janelia-experimental-technology/Dual-PMT-Amplifier/README.md

# Dual-PMT-Amplifier
Dual amplifier for PMTs
