janelia-experimental-technology/Dual-PMT-Amplifier/ECAD/PMT AMP_J000331REVH_BOM.xlsx

Qty | Value | Device | Package | Parts | Description | MANUFACTURER | MANUFACTURER PN | DIGIKEY PART NUMBER
6 | DNP | M01PTH | 1X01 | OUT1, OUT2, V+, V-, V2+, V2- | Header 1 | - | - | -
2 | 1x02 | M02LOCK | 1X02_LOCK | JP1, JP2 | Header 2 | Wurth | 61300211121 | 732-5315-ND (https://www.digikey.com/product-detail/en/wurth-electronics-inc/61300211121/732-5315-ND/4846823)
2 | 49.9 | RESISTOR-POWER2512WIDE | 2512LONG | R3, R23 | RES SMD 49.9 OHM 2W 2512 WIDE | Vishay Dale | RCL122549R9FKEG | RCL49.9ECT-ND (https://www.digikey.com/product-detail/en/vishay-dale/RCL122549R9FKEG/RCL49.9ECT-ND/3029233)
6 | 227161 | 5227161-9 | AMP_227161 | J2, J4, J5, J6, J7, J8 | JACK, RIGHT ANGLE, 50 OHM, PCB, BNC | TE Connectivity | 5227161-9 | A32261-ND (https://www.digikey.com/product-detail/en/te-connectivity-amp-connectors/5227161-9/A32261-ND/811159)
6 |  | 1-1634816-0 | AMP_227161 | J2, J4, J5, J6, J7, J8 | CONN NUT FOR BNC AND TNC CONN | TE Connectivity | 1-1634816-0 | A97566-ND (https://www.digikey.com/product-detail/en/te-connectivity-amp-connectors/1-1634816-0/A97566-ND/1755953)
6 |  | 1-1634817-0 | AMP_227161 | J2, J4, J5, J6, J7, J8 | CONN LOCKWSH FOR BNC & TNC CONN | TE Connectivity | 1-1634817-0 | A97567-ND (https://www.digikey.com/product-detail/en/te-connectivity-amp-connectors/1-1634817-0/A97567-ND/1755954)
16 | 0.1u | C-EUC0603 | C0603 | C8, C9, C10, C11, C12, C13, C14, C15, C28, C29, C30, C31, C32, C33, C34, C35 | CAPACITOR, European symbol | Vishay Vitramon | VJ0603Y104JXXAC | 720-1545-1-ND (https://www.digikey.com/product-detail/en/vishay-vitramon/VJ0603Y104JXXAC/720-1545-1-ND/6096542)
2 | 3.3n | C-EUC0805 | C0805 | C7, C27 | CAPACITOR, European symbol | KEMET | C0805C332F3GACTU | 399-8066-1-ND (https://www.digikey.com/product-detail/en/kemet/C0805C332F3GACTU/399-8066-1-ND/3471789)
2 | 4.7n | C-EUC0805 | C0805 | C5, C25 | CAPACITOR, European symbol | KEMET | C0805C472GAGAC7800 | 399-13494-1-ND (https://www.digikey.com/product-detail/en/kemet/C0805C472GAGAC7800/399-13494-1-ND/6126230)
2 | 68n | C-EUC0805 | C0805 | C6, C26 | CAPACITOR, European symbol | KEMET | C0805C683J5RAC7800 | 399-14629-1-ND (https://www.digikey.com/product-detail/en/kemet/C0805C683J5RAC7800/399-14629-1-ND/7103921)
2 | DNP | C-EUC0805 | C0805 | C100, C200 | CAPACITOR, European symbol | - | - | -
8 | 10u | C-EUC1206 | C1206 | C1, C2, C3, C4, C21, C22, C23, C24 | CAPACITOR, European symbol | KEMET | C1206C106J3RACAUTO | 399-15734-1-ND (https://www.digikey.com/product-detail/en/kemet/C1206C106J3RACAUTO/399-15734-1-ND/7427614)
4 | 1p | C-EUC1206 | C1206 | CF1A, CF1B, CF2A, CF2B | CAPACITOR, European symbol | KEMET | C1206C109C5GACTU | 399-1178-1-ND (https://www.digikey.com/product-detail/en/kemet/C1206C109C5GACTU/399-1178-1-ND/411453)
2 | LSM115J | DIODE-DO214BA | DO214BA | D1, D2 | DIODE | Microsemi | LSM115JE3/TR13 | LSM115JE3/TR13CT-ND (https://www.digikey.com/product-detail/en/microsemi-corporation/LSM115JE3-TR13/LSM115JE3-TR13CT-ND/1634547)
4 | PJ-002BH | POWER_JACK_SHUNTPJ-002 | PJ-002 | J1, J3, J9, J10 | CONN PWR JACK 2.5X5.5MM SOLDER | CUI | PJ-002BH-SMT-TR | CP-002BHPJTR-ND (https://www.digikey.com/product-detail/en/cui-inc/PJ-002BH-SMT-TR/CP-002BHPJTR-ND/404626)
4 | 0 | R-US_R0805 | R0805 | R100, R200, RIN1, RIN2 | RESISTOR, American symbol | Vishay Dale | CRCW08050000Z0EA | 541-0.0ACT-ND (https://www.digikey.com/product-detail/en/vishay-dale/CRCW08050000Z0EA/541-0.0ACT-ND/1180267)
4 | 100k | R-US_R0805 | R0805 | R10, R11, R30, R31 | RESISTOR, American symbol | Vishay Dale | TNPW0805100KBEEA | TNP100KABCT-ND (https://www.digikey.com/product-detail/en/vishay-dale/TNPW0805100KBEEA/TNP100KABCT-ND/1857093)
4 | 10k | R-US_R0805 | R0805 | R7, R8, R27, R28 | RESISTOR, American symbol | Vishay Dale | TNPW080510K0BEEA | TNP10.0KABCT-ND (https://www.digikey.com/product-detail/en/vishay-dale/TNPW080510K0BEEA/TNP10.0KABCT-ND/1857095)
4 | 3.74k | R-US_R0805 | R0805 | R4, R5, R24, R25 | RESISTOR, American symbol | Vishay Dale | TNPW08053K74BEEA | 541-3791-1-ND (https://www.digikey.com/product-detail/en/vishay-dale/TNPW08053K74BEEA/541-3791-1-ND/7355150)
2 | 37.4k | R-US_R0805 | R0805 | R6, R26 | RESISTOR, American symbol | Vishay Dale | TNPW080537K4BEEA | 541-3779-1-ND (https://www.digikey.com/product-detail/en/vishay-dale/TNPW080537K4BEEA/541-3779-1-ND/7355138)
4 | 715 | R-US_R0805 | R0805 | R2, R9, R22, R29 | RESISTOR, American symbol | Vishay Dale | CRCW0805715RFKEA | 541-715CCT-ND (https://www.digikey.com/product-detail/en/vishay-dale/CRCW0805715RFKEA/541-715CCT-ND/1180767)
2 | 75 | R-US_R0805 | R0805 | R1, R21 | RESISTOR, American symbol | Vishay Dale | CRCW080575R0JNEA | 541-75ACT-ND (https://www.digikey.com/product-detail/en/vishay-dale/CRCW080575R0JNEA/541-75ACT-ND/1180313)
2 | DNP | R-US_R0805 | R0805 | R101, R201 | RESISTOR, American symbol | - | - | -
2 | 20k | R-US_R1206 | R1206 | RF1, RF2 | RESISTOR, American symbol | Vishay Dale | TNPW120620K0BEEA | TNP20.0KACCT-ND (https://www.digikey.com/product-detail/en/vishay-dale/TNPW120620K0BEEA/TNP20.0KACCT-ND/1857150)
2 | 100k | R-US_R1206 | R1206 | RF1, RF2 | RESISTOR, American symbol | Vishay Dale | TNPW1206100KBEEA | TNP100KACCT-ND (https://www.digikey.com/products/en?keywords=%20%09TNP100KACCT-ND%20)
4 | 100k | R-TRIMM3006P | RTRIM3006P | R12, R13, R32, R33 | Trimm resistor | BOURNS | 3006P-1-104LF | 3006P-104LF-ND (https://www.digikey.com/products/en?keywords=3006p-1-104lf)
4 |  | SOLDERJUMPER_2WAYS | SJ_3 | FST1, FST2, SLW1, SLW2 | Solder Jumper | - | - | -
2 | OP400G | OP400SO16_W | SO16L | U2, U6 | OP AMP | Analog Devices | OP400GSZ | OP400GSZ-ND (https://www.digikey.com/product-detail/en/analog-devices-inc/OP400GSZ/OP400GSZ-ND/654260)
2 | OPA692 | AD820R | SO8 | U5, U10 | Single-Supply, Rail-to-Rail, Low Power, FET Input Op Amp | Texas Instruments | OPA692ID | OPA692ID-ND (https://www.digikey.com/product-detail/en/texas-instruments/OPA692ID/OPA692ID-ND/459282)
2 | OPA657 | AD820R | SO8 | U4, U9 | Single-Supply, Rail-to-Rail, Low Power, FET Input Op Amp | Texas Instruments | OPA657UB | OPA657UB-ND (https://www.digikey.com/product-detail/en/texas-instruments/OPA657UB/OPA657UB-ND/431976)
2 | MC78L05ACHX | 78LXXSOT89 | SOT89 | U1, U8 | VOLTAGE REGULATOR | ON Semiconductor | MC78L05ACHX | MC78L05ACHXCT-ND (https://www.digikey.com/product-detail/en/on-semiconductor/MC78L05ACHX/MC78L05ACHXCT-ND/2053106)
2 | MC79L05ACHX | 79LXXSOT89 | SOT89 | U3, U7 | VOLTAGE REGULATOR | ON Semiconductor | MC79L05ACHX | MC79L05ACHXCT-ND (https://www.digikey.com/product-detail/en/on-semiconductor/MC79L05ACHX/MC79L05ACHXCT-ND/3907987)
2 |  | PowerSupply |  |  | 5.4 Watt AC/DC Unregulated Linear Wall Adapter | Jameco | 100175 (https://www.jameco.com/webapp/wcs/stores/servlet/ProductDisplay?productId=100175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)
