janelia-experimental-technology/Dual-PMT-Amplifier/MCAD/PMT AMP Rear Panel.stp

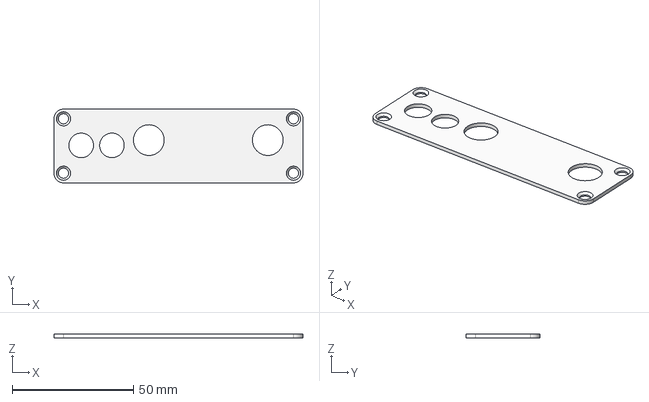
[picture p4: CAD file, 2025-08-05]
MCAD/PMT AMP Rear Panel.stp
102.9 x 30.5 x 1.50 mm
