janelia-experimental-technology/Dual-PMT-Amplifier/MCAD/PMT AMP Front Panel.stp

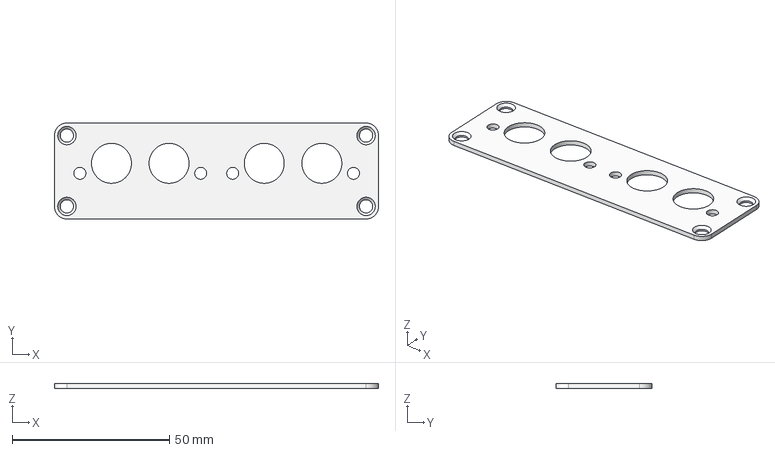
[picture p5: CAD file, 2025-08-05]
MCAD/PMT AMP Front Panel.stp
102.9 x 30.5 x 1.50 mm
