janelia-experimental-technology/Dual-PMT-Amplifier/(list of files, cad)

Other CAD files:
MCAD/PMT_AMP_REAR_PANEL_DUAL_REVA.dwg
MCAD/LABEL_NO_MECH.dwg
MCAD/PMT_AMP_FRONT_PANEL_DUAL.dwg
