janelia-experimental-technology/Dual-PMT-Amplifier/ECAD/PMT AMP_J000331REVH.pdf

2/12/2018 10:44 AM f=0.65 I:\PROJECTS\ID&F\PMT AMPLIFIER\ECAD\PMT AMP_J000331REVH\PMT AMP_J000331REVH.sch (Sheet: 1/2) SpiceOrder 1 SpiceOrder 2

# 10uGND

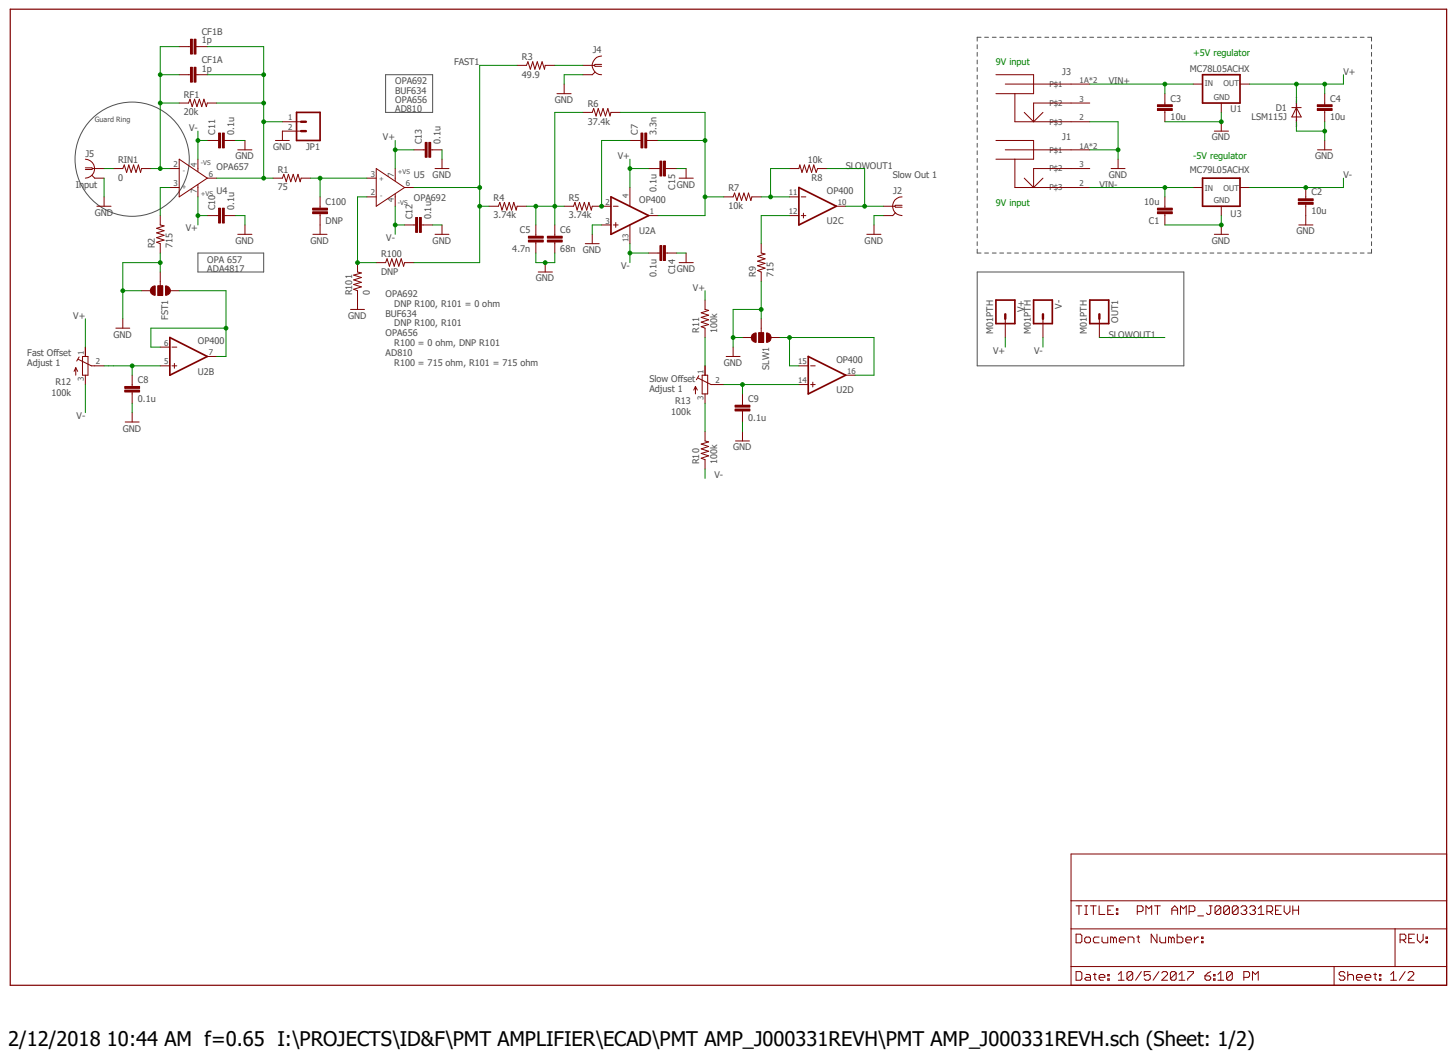
[picture p6: page 1]

49.9 0.1u GND⁰.1u GND 0.1u GND ⁰.1u GND

2/12/2018 10:44 AM f=0.65 I:\PROJECTS\ID&F\PMT AMPLIFIER\ECAD\PMT AMP_J000331REVH\PMT AMP_J000331REVH.sch (Sheet: 2/2) SpiceOrder 1 SpiceOrder 2

# 10uGND

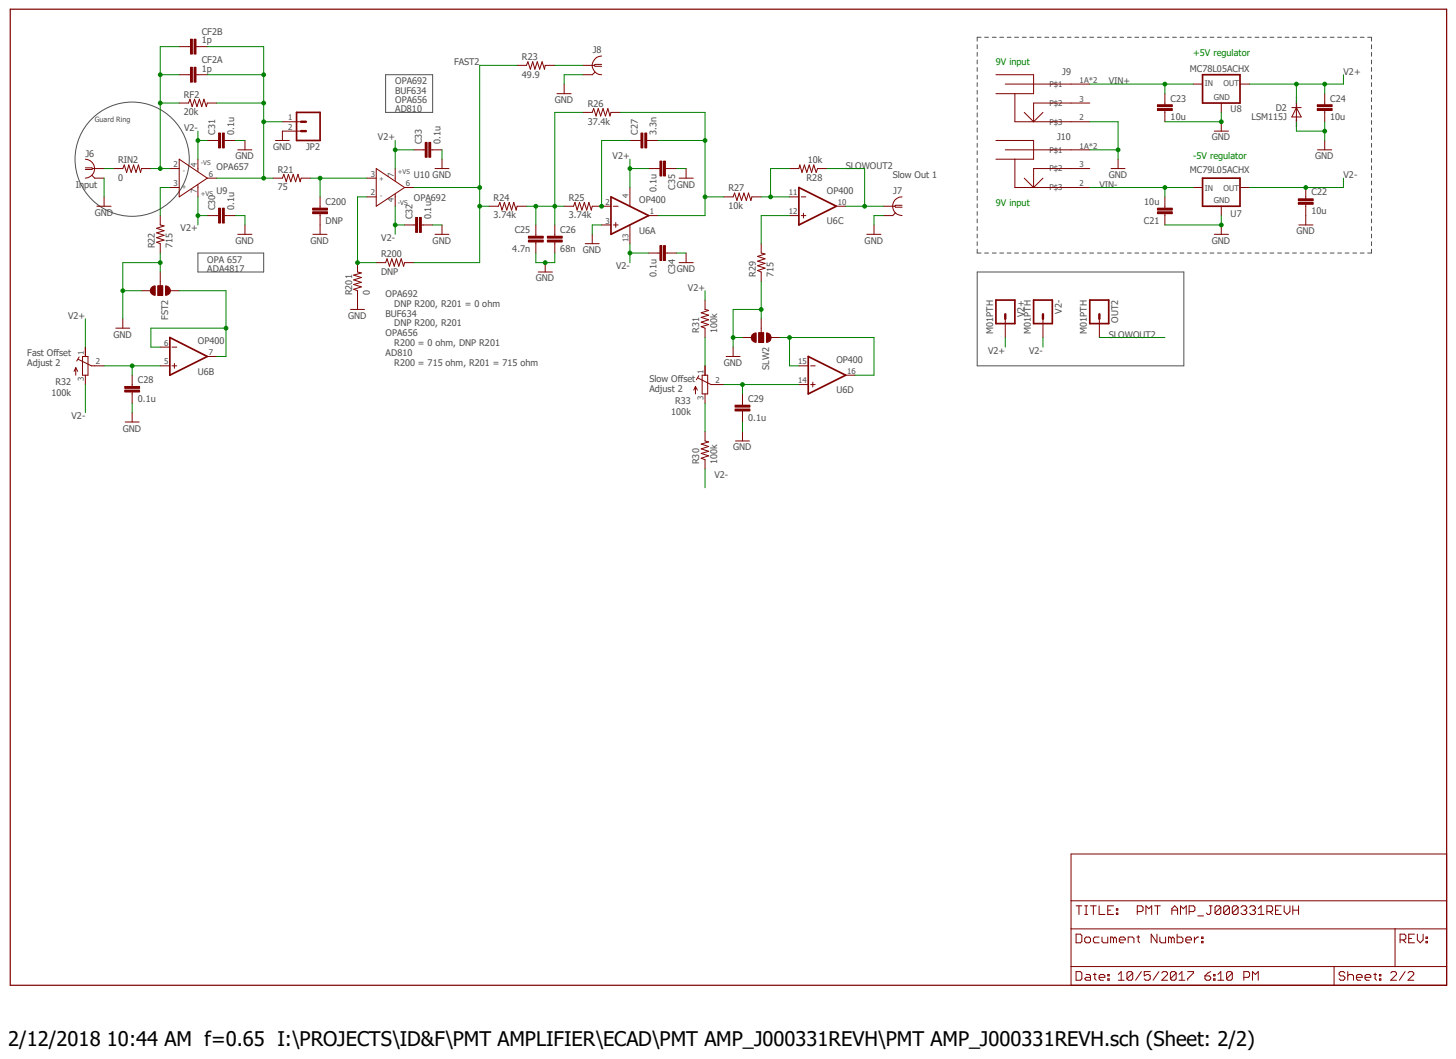
[picture p7: page 2]

49.9 0.1u GND⁰.1u GND 0.1u GND ⁰.1u GND
