janelia-experimental-technology/Dual-PMT-Amplifier/ECAD/PMT AMP_J000331REVH_pcb.pdf

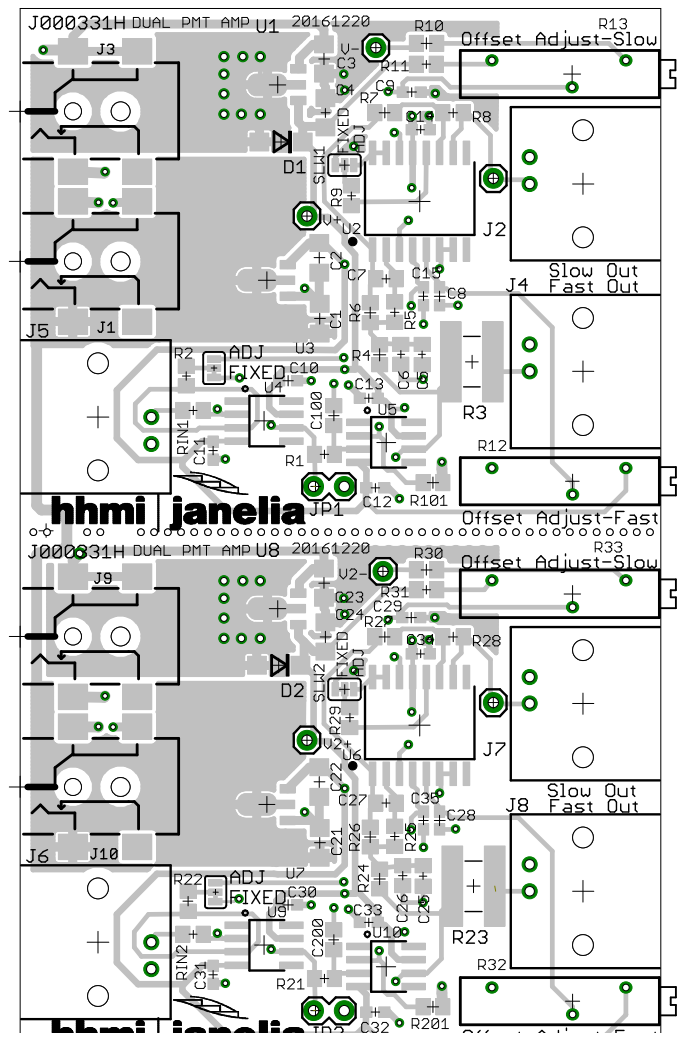
[picture p8: page 1]
