janelia-experimental-technology/Dual-PMT-Amplifier/ECAD/PMT AMP_J000331REVH.brd

## EAGLE design ECAD/PMT AMP_J000331REVH.brd (2025-08-05)

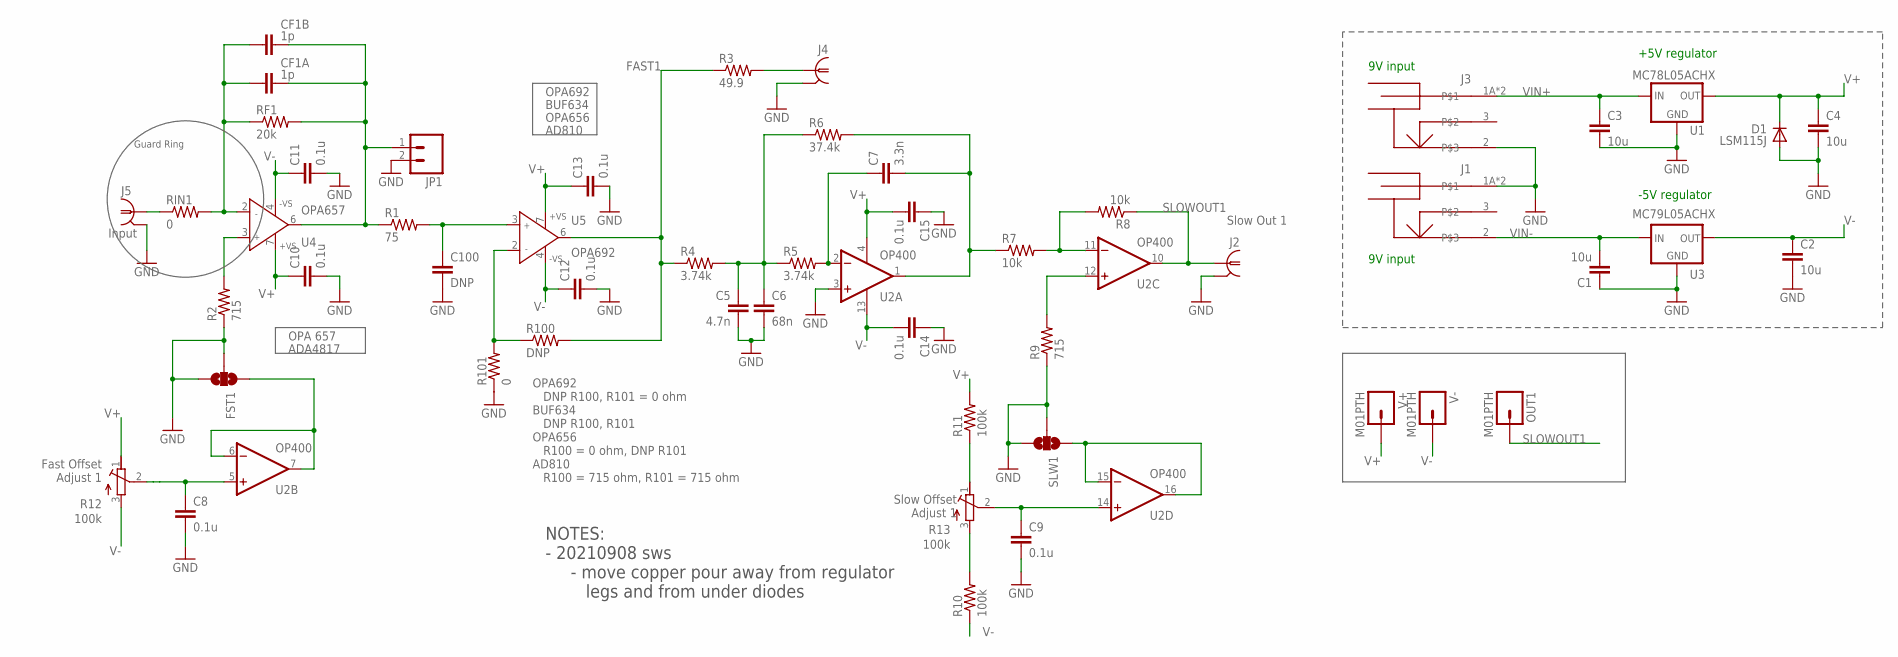
[picture p9: schematic PMT AMP_J000331REVH.sch, sheet 1]

Parts:
C1, C2, C3, C4: 10u; C1206
C5: 4.7n; C0805
C6: 68n; C0805
C7: 3.3n; C0805
C8, C9, C10, C11, C12, C13, C14, C15: 0.1u; C0603
C100: DNP; C0805
CF1A, CF1B: 1p; C1206
D1: LSM115J; DO214BA
FST1: SOLDERJUMPER_2WAYS; SJ_3
J1, J3: POWER_JACK_SHUNTPJ-002; PJ-002
J2, J4, J5: 1-227161-0; AMP_227161; MPN 5413879-1
JP1: M02LOCK; 1X02_LOCK
OUT1: M01PTH; 1X01
R1: 75; R0805
R2, R9: 715; R0805
R3: 49.9; 2512LONG
R4, R5: 3.74k; R0805
R6: 37.4k; R0805
R7, R8: 10k; R0805
R10, R11: 100k; R0805
R12, R13: 100k; RTRIM3006P; MPN 3006P-1-104LF
R100: DNP; R0805
R101: 0; R0805
RF1: 20k; R1206
RIN1: 0; R0805
SLW1: SOLDERJUMPER_2WAYS; SJ_3
U1: MC78L05ACHX; SOT89
U2: OP400; SO16L
U3: MC79L05ACHX; SOT89
U4: OPA657; SO8
U5: OPA692; SO8
V+: M01PTH; 1X01
V-: M01PTH; 1X01

Connections:
FAST1: R3.1, R4.1, R100.2, U5.6 (OUT)
FO1: J4.1, R3.2
GND: C1.1, C2.2, C3.2, C4.2, C5.2, C6.2, C8.2, C9.2, C10.2, C11.2, C12.2, C13.2, C14.1, C15.1, C100.2, D1.A, FST1.2, FST1.3, J1.1A, J1.1B, J2.2 (GND), J3.2, J4.2 (GND), J5.2 (GND), JP1.2, R2.1, R9.1, R101.1, SLW1.2, SLW1.3, U1.2 (GND), U1.2@1 (GND), U2.3 (+IN), U3.1 (GND); also elsewhere on the board
unnamed: CF1A.1, CF1B.1, RF1.1, RIN1.2, U4.2 (IN-)
unnamed: R7.2, R8.2, U2.11 (-IN)
unnamed: C100.1, R1.2, U5.3 (IN+)
unnamed: C8.1, R12.2 (S), U2.5 (+IN)
unnamed: C9.1, R13.2 (S), U2.14 (+IN)
unnamed: R11.1, R13.1 (E)
unnamed: R10.2, R13.3 (A)
unnamed: J5.1, RIN1.1
unnamed: R100.1, R101.2, U5.2 (IN-)
unnamed: C7.1, R5.2, U2.2 (-IN)
unnamed: SLW1.1, U2.15 (-IN), U2.16 (OUT)
unnamed: FST1.1, U2.6 (-IN), U2.7 (OUT)
unnamed: C7.2, R6.2, R7.1, U2.1 (OUT)
unnamed: C5.1, C6.1, R4.2, R5.1, R6.1
unnamed: R9.2, U2.12 (+IN)
unnamed: R2.2, U4.3 (IN+)
SLOWOUT1: J2.1, OUT1.1, R8.1, U2.10 (OUT)
U4OUT1: CF1A.2, CF1B.2, JP1.1, R1.1, RF1.2, U4.6 (OUT)
V+: C4.1, C10.1, C13.1, C15.2, D1.C, R11.2, R12.1 (E), U1.1 (OUT), U2.4 (V+), U4.7 (+VS), U5.7 (+VS), V+.1
V-: C2.1, C11.1, C12.1, C14.2, R10.1, R12.3 (A), U2.13 (V-), U3.3 (OUT), U4.4 (-VS), U5.4 (-VS), V-.1
VIN+: C3.1, J3.1A, J3.1B, U1.3 (IN); also elsewhere on the board
VIN-: C1.2, J1.2, U3.2 (IN), U3.2@1 (IN); also elsewhere on the board

Notes on the sheet:
9V input
+5V regulator
-5V regulator
OPA 657
ADA4817
OPA692
OPA656
AD810
Slow Offset Adjust 1
Fast Offset Adjust 1
Slow Out 1
Input
OPA692 DNP R100, R101 = 0 ohm BUF634 DNP R100, R101 OPA656 R100 = 0 ohm, DNP R101 AD810 R100 = 715 ohm, R101 = 715 ohm
Guard Ring
BUF634
NOTES: - 20210908 sws - move copper pour away from regulator legs and from under diodes

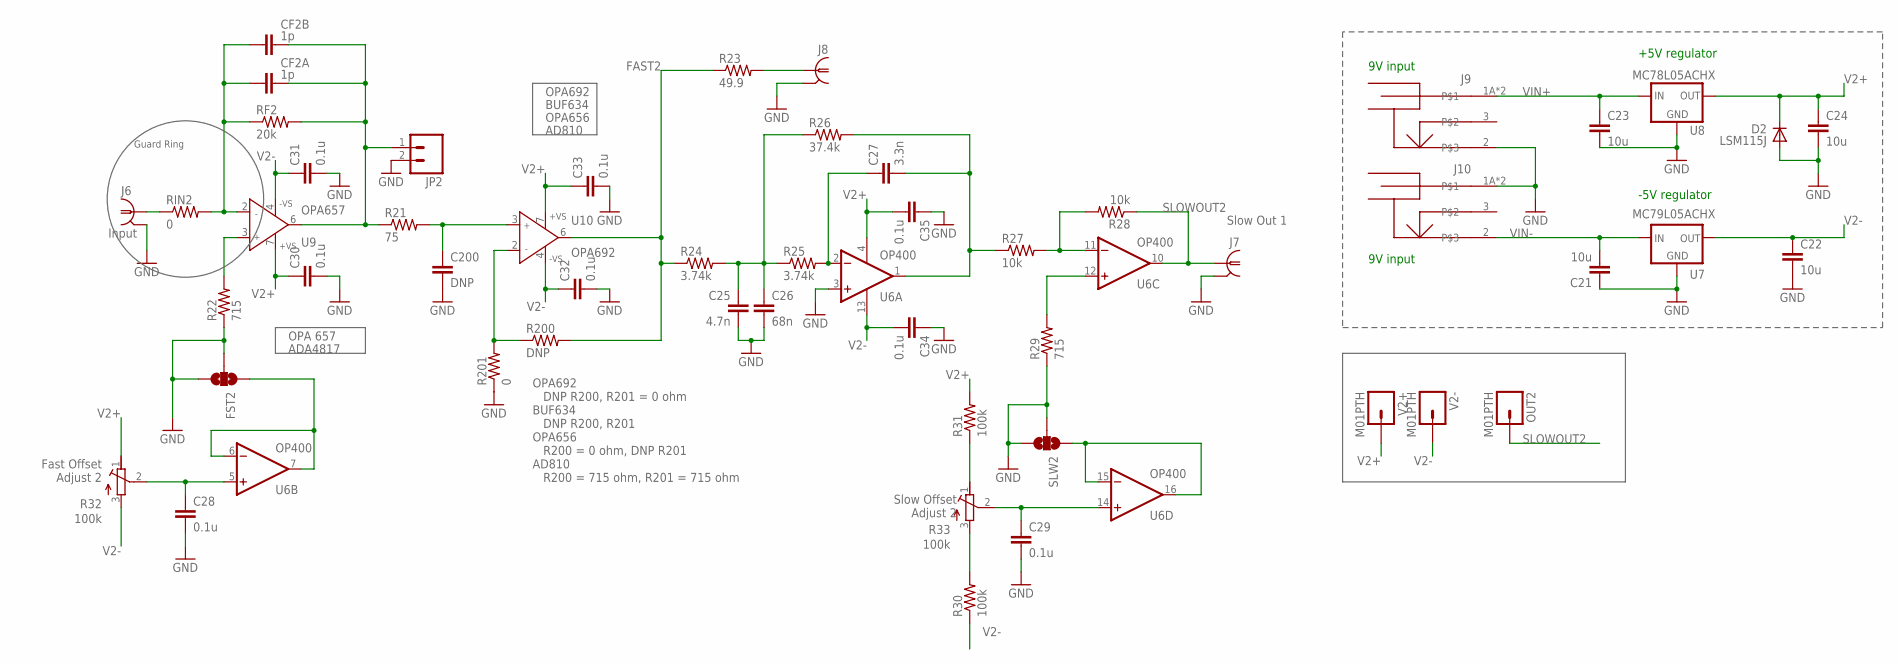
[picture p10: schematic PMT AMP_J000331REVH.sch, sheet 2]

Parts:
C21, C22, C23, C24: 10u; C1206
C25: 4.7n; C0805
C26: 68n; C0805
C27: 3.3n; C0805
C28, C29, C30, C31, C32, C33, C34, C35: 0.1u; C0603
C200: DNP; C0805
CF2A, CF2B: 1p; C1206
D2: LSM115J; DO214BA
FST2: SOLDERJUMPER_2WAYS; SJ_3
J6, J7, J8: 1-227161-0; AMP_227161; MPN 5413879-1
J9, J10: POWER_JACK_SHUNTPJ-002; PJ-002
JP2: M02LOCK; 1X02_LOCK
OUT2: M01PTH; 1X01
R21: 75; R0805
R22, R29: 715; R0805
R23: 49.9; 2512LONG
R24, R25: 3.74k; R0805
R26: 37.4k; R0805
R27, R28: 10k; R0805
R30, R31: 100k; R0805
R32, R33: 100k; RTRIM3006P; MPN 3006P-1-104LF
R200: DNP; R0805
R201: 0; R0805
RF2: 20k; R1206
RIN2: 0; R0805
SLW2: SOLDERJUMPER_2WAYS; SJ_3
U6: OP400; SO16L
U7: MC79L05ACHX; SOT89
U8: MC78L05ACHX; SOT89
U9: OPA657; SO8
U10: OPA692; SO8
V2+, V2-: M01PTH; 1X01

Connections:
FAST2: R23.1, R24.1, R200.2, U10.6 (OUT)
FO2: J8.1, R23.2
GND: C21.1, C22.2, C23.2, C24.2, C25.2, C26.2, C28.2, C29.2, C30.2, C31.2, C32.2, C33.2, C34.1, C35.1, C200.2, D2.A, FST2.2, FST2.3, J6.2 (GND), J7.2 (GND), J8.2 (GND), J9.2, J10.1A, J10.1B, JP2.2, R22.1, R29.1, R201.1, SLW2.2, SLW2.3, U6.3 (+IN), U7.1 (GND), U8.2 (GND), U8.2@1 (GND); also elsewhere on the board
unnamed: CF2A.1, CF2B.1, RF2.1, RIN2.2, U9.2 (IN-)
unnamed: J6.1, RIN2.1
unnamed: C200.1, R21.2, U10.3 (IN+)
unnamed: R200.1, R201.2, U10.2 (IN-)
unnamed: C28.1, R32.2 (S), U6.5 (+IN)
unnamed: C27.1, R25.2, U6.2 (-IN)
unnamed: C29.1, R33.2 (S), U6.14 (+IN)
unnamed: C27.2, R26.2, R27.1, U6.1 (OUT)
unnamed: SLW2.1, U6.15 (-IN), U6.16 (OUT)
unnamed: R27.2, R28.2, U6.11 (-IN)
unnamed: R31.1, R33.1 (E)
unnamed: R30.2, R33.3 (A)
unnamed: C25.1, C26.1, R24.2, R25.1, R26.1
unnamed: FST2.1, U6.6 (-IN), U6.7 (OUT)
unnamed: R29.2, U6.12 (+IN)
unnamed: R22.2, U9.3 (IN+)
SLOWOUT2: J7.1, OUT2.1, R28.1, U6.10 (OUT)
U9OUT1: CF2A.2, CF2B.2, JP2.1, R21.1, RF2.2, U9.6 (OUT)
V2+: C24.1, C30.1, C33.1, C35.2, D2.C, R31.2, R32.1 (E), U6.4 (V+), U8.1 (OUT), U9.7 (+VS), U10.7 (+VS), V2+.1
V2-: C22.1, C31.1, C32.1, C34.2, R30.1, R32.3 (A), U6.13 (V-), U7.3 (OUT), U9.4 (-VS), U10.4 (-VS), V2-.1
VIN+: C23.1, J9.1A, J9.1B, U8.3 (IN); also elsewhere on the board
VIN-: C21.2, J10.2, U7.2 (IN), U7.2@1 (IN); also elsewhere on the board

Notes on the sheet:
9V input
+5V regulator
-5V regulator
OPA 657
ADA4817
OPA692
OPA656
AD810
Slow Offset Adjust 2
Fast Offset Adjust 2
Slow Out 1
Input
OPA692 DNP R200, R201 = 0 ohm BUF634 DNP R200, R201 OPA656 R200 = 0 ohm, DNP R201 AD810 R200 = 715 ohm, R201 = 715 ohm
Guard Ring
BUF634

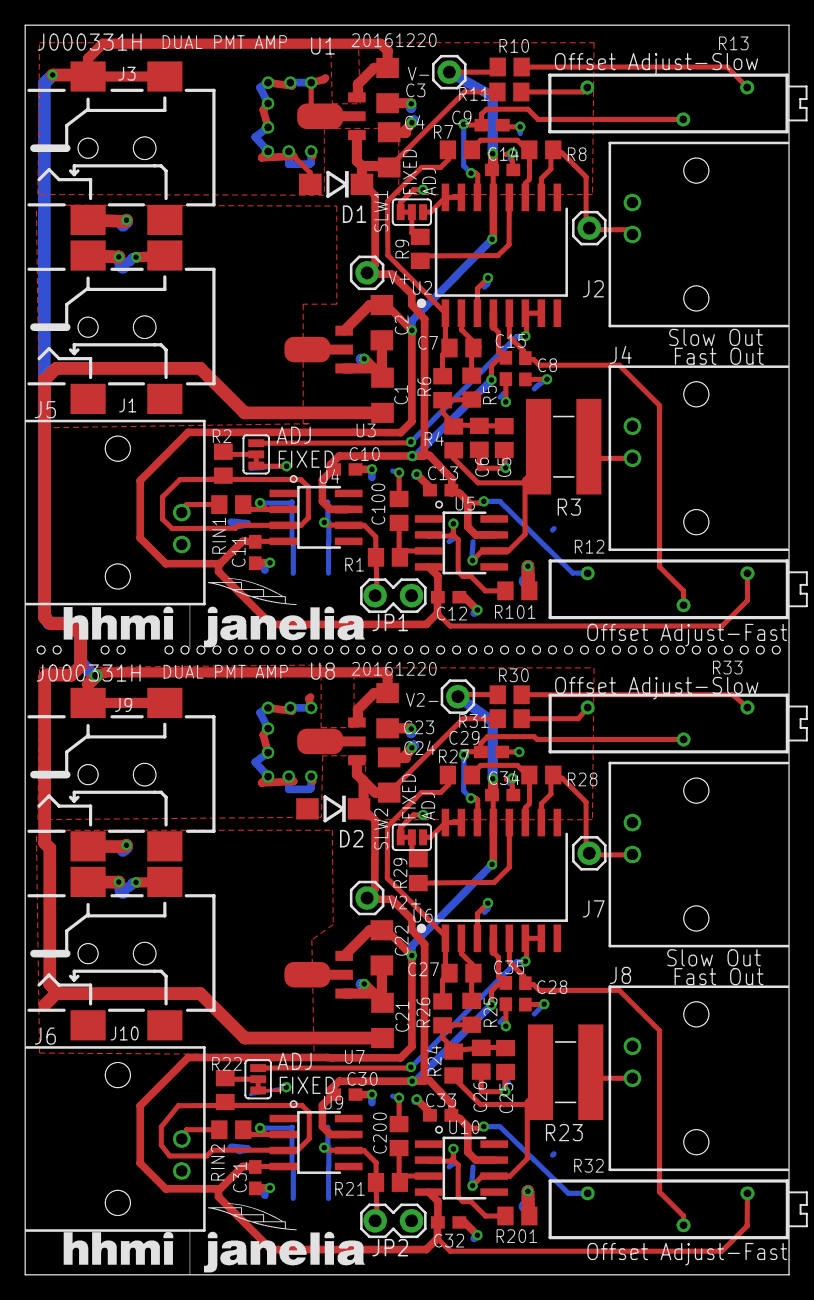
[picture p11: board PMT AMP_J000331REVH.brd from above]

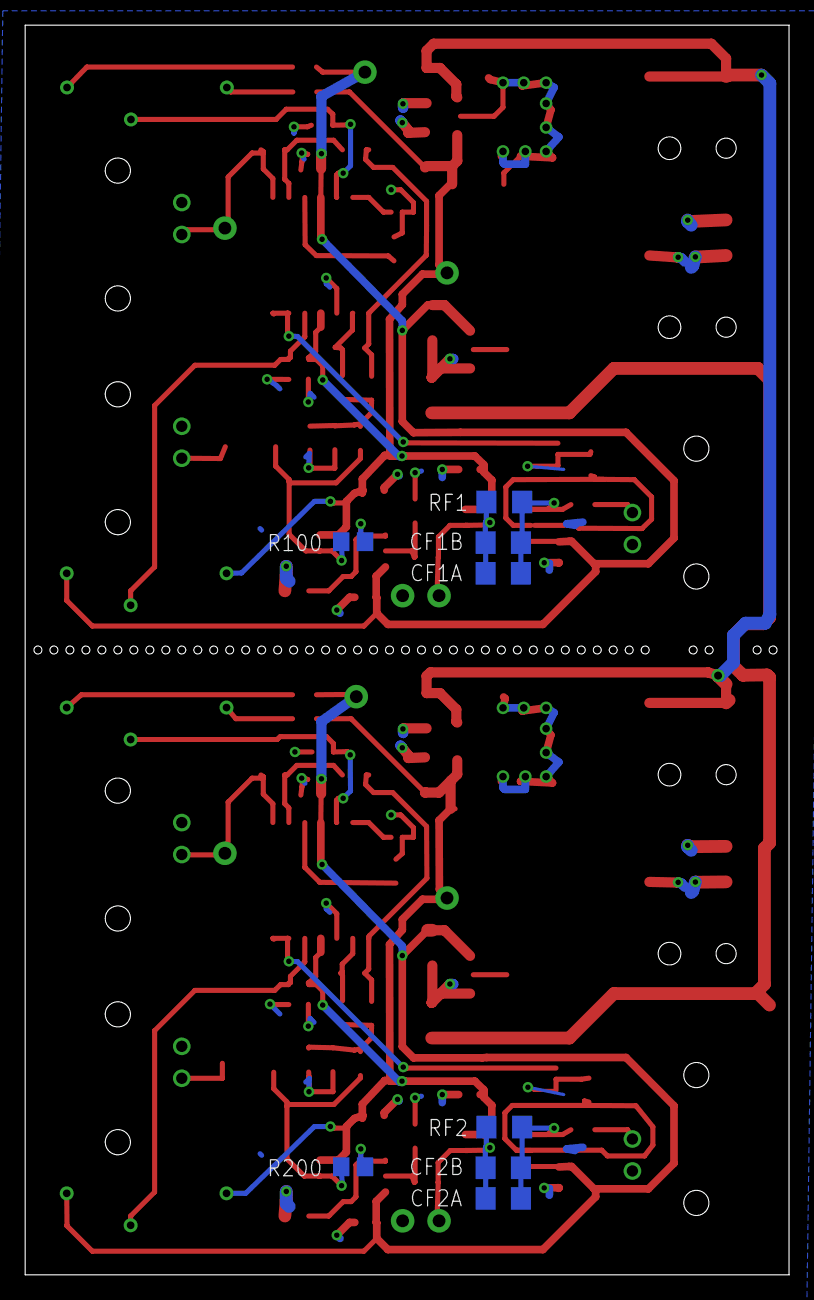
[picture p12: board PMT AMP_J000331REVH.brd from below]

Board: 2 copper layers, 60.7 x 99.3 mm, 106 parts (8 on the bottom side), 47 nets.

Other parts of the board:
U$1, U$2: JFRC-LOGOLOGO_JANELIA_2014; LOGO_JANELIA_2014
